MinhTran2084/Fliptris_Console/Media/Back view.jpg

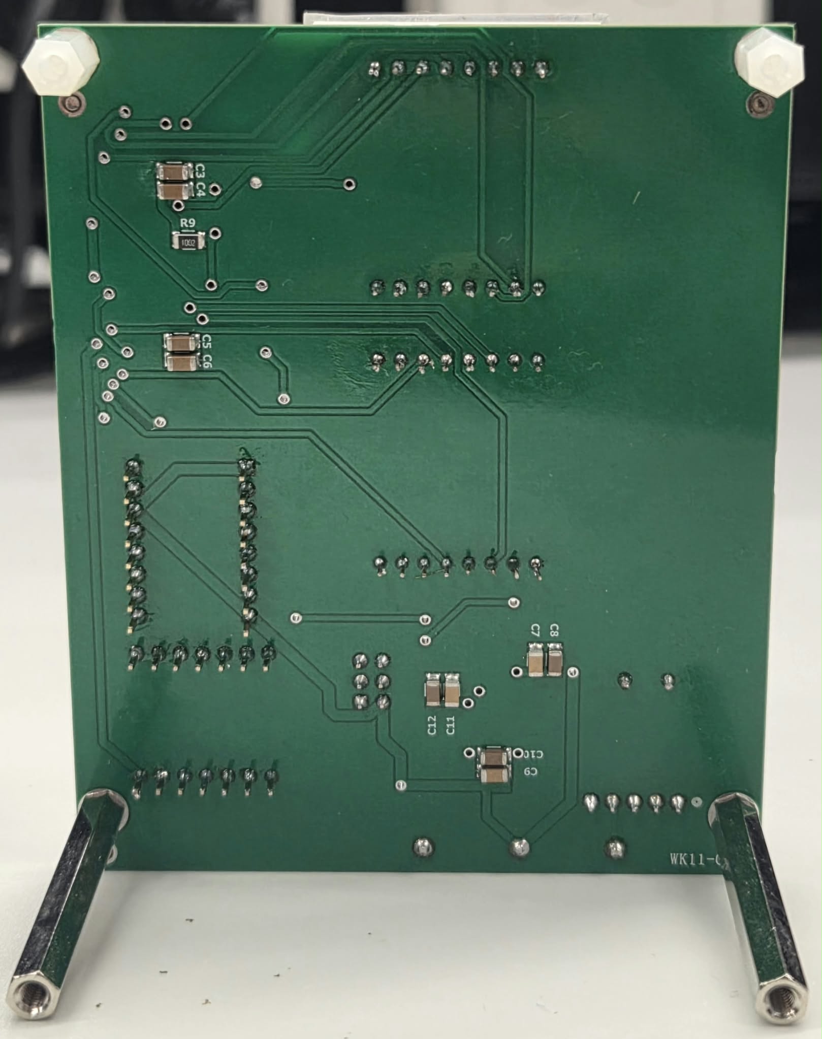
Media/Back view.jpg
