MinhTran2084/Fliptris_Console/Media/Front view.jpg

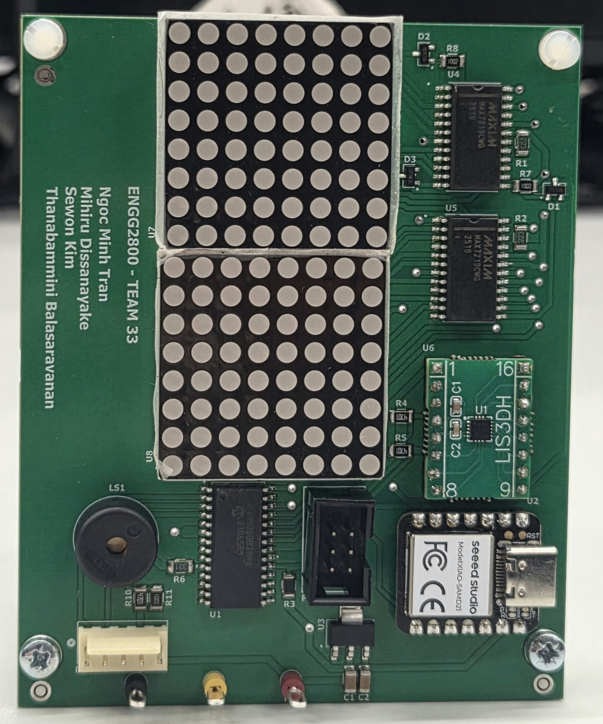
Media/Front view.jpg
