MinhTran2084/Fliptris_Console/Hardware_Altium/Documents/BOM.xlsx

Designator | Description | Quantity | Unit Price | Total price | Manufacturer | Manufacturer # | Supplier | Supplier # | RoHS link
U1 | IC MCU 8BIT 128KB FLASH 28SOIC | 1 | $2.66 | $2.66 | Microchip Technology | AVR128DB28-I/SO | DigiKey | 150-AVR128DB28-I/SO-ND | https://www.digikey.com.au/en/products/detail/microchip-technology/AVR128DB28-I-SO/12807360
U2 | Seeeduino Xiao SAMD21 | 1 | $8.25 | $8.25 | Seeed Studio | 102010328 | ETSG | 24-01-01 | See ETSG
U3 | IC REG LINEAR 3.3V 800MA SOT-223 | 1 | $0.89 | $0.89 | onsemi | LM1117MPX-33NOPB | DigiKey | 488-LM1117MPX-33NOPBTR-ND | https://www.digikey.com.au/en/products/detail/onsemi/LM1117MPX-33NOPB/13559871
U4, U5 | IC DRVR 7 SEGMNT 8 DIGIT 24SOIC | 2 | $29.67 | $59.34 | Analog Devices Inc./Maxim Integrated | MAX7219CWG+T | DigiKey | MAX7219CWG+TTR-ND | https://www.digikey.com.au/en/products/detail/analog-devices-inc-maxim-integrated/MAX7219CWG-T/1514450
U6 | LIS3DH Accelerometer Breakout | 1 | $2.40 | $2.40 | ETSG | 07-40-01 | ETSG | 07-40-01 | See ETSG
U7, U8 | 8x8 LED Matrix | 2 | $6.36 | $12.72 | Luckylight Electronics Co., Ltd. | KWM-30881CVB | ETSG | 28-06-05 | See ETSG
P1 | 2x3 Pin Header (UPDI) | 1 | $2.61 | $2.61 | ETSG | 01-77-01 | ETSG | 01-77-01 | See ETSG
P2 | KK Style Vertical Male Header (5 Pin) | 1 | $0.03 | $0.03 | ETSG | 24-03-02 | ETSG | 24-03-02 | See ETSG
P3 | KK Style Crimp Terminal Housing (5 Way) | 1 | $0.02 | $0.02 | ETSG | 24-03-04 | ETSG | 24-03-04 | See ETSG
P4, P5, P6, P7, P8 | KK Style Crimp Terminals | 5 | $0.01 | $0.05 | ETSG | 24-03-01 | ETSG | 24-03-01 | See ETSG
D1, D2, D3 | DIODE SMT Schottky Barrier | 3 | $0.42 | $1.26 | Infineon Technologies | BAT5404E6327HTSA1 | ETSG | 63-07-12 | See datasheet
TP1 | Red Test Point | 1 | $0.38 | $0.38 | Keystone Electronics | 5010 | ETSG | 01-95-01 | See ETSG
TP2 | Yellow Test Point | 1 | $0.40 | $0.40 | Keystone Electronics | 5011 | ETSG | 01-95-02 | See ETSG
TP3 | Black Test Point | 1 | $0.40 | $0.40 | Keystone Electronics | 5014 | ETSG | 01-96-01 | See ETSG
C1, C2, C4, C6 | CAP CER 10UF 25V X7R 1206 | 4 | $0.22 | $0.88 | Murata Electronics | GRM31CR71E106KA12L | ETSG | 62-01-07 | See datasheet
C3, C5, C8, C10, C12 | CAP CER 0.1uF 10V X7R 1206 | 5 | $0.17 | $0.85 | Würth Elektronik | 885012208009 | ETSG | 64-07-07 | See datasheet
C7, C9, C11 | CAP CER 1UF 10V X7R 1206 | 3 | $0.31 | $0.93 | Würth Elektronik | 885012208013 | DigiKey | 732-7685-2-ND | See datasheet
R1, R2 | 22K 1% 1/4W 1206 Resistor | 2 | $0.08 | $0.16 | Tyco Electronics | CRG1206F22K | ETSG | 63-04-08 | See datasheet
R3 | 1K 1% 1/4W 1206 Resistor | 1 | $0.02 | $0.02 | Tyco Electronics | CRG1206F1K0 | ETSG | 63-03-05 | See datasheet
R4, R5, R10 | 4.7K 1% 1/4W 1206 Resistor | 3 | $0.08 | $0.24 | Tyco Electronics | CRG1206F4K7 | ETSG | 63-04-01 | See datasheet
R6 | 330R 1% 1/4W 1206 Resistor | 1 | $0.08 | $0.08 | Tyco Electronics | CRG1206F330R | ETSG | 63-03-01 | See datasheet
R7, R8, R9, R11 | 10K 1% 1/4W 1206 Resistor | 4 | $0.01 | $0.04 | Tyco Electronics | CRG1206F10K | ETSG | 63-04-05 | See datasheet
LS1 | BUZZER PIEZO 3V 12.2MM TH | 1 | $1.08 | $1.08 | TDK | PS1240P02BT | DigiKey | 445-2525-1-ND | See datasheet
PCB | Custom Game Board (10x8.1cm) | 1 | $2.86 | $2.86 | — | — | Pinecone | https://pinecone2.uqcloud.net/pcb/6abf65aee9f09bf046ebfc34
HW1, HW2 | M3x9 Nylon F-F Standoff | 2 | $0.20 | $0.40 | ETSG | 10-41-02 | ETSG | 10-41-02 | See ETSG
HW3, HW4 | M3x40 Brass Nickel Plated F-F Standoff | 2 | $0.94 | $1.88 | ETSG | 10-44-03 | ETSG | 10-44-03 | See ETSG
HW5, HW6 | M3x6 Nylon Screw | 2 | $0.13 | $0.26 | ETSG | 10-34-01 | ETSG | 10-34-01 | See ETSG
HW7, HW8 | M3x6 Zinc Plated Steel Supadriv Screw | 2 | $0.06 | $0.12 | ETSG | 10-66-01 | ETSG | 10-66-01 | See ETSG
Total: |  |  |  | $101.21
