MinhTran2084/Fliptris_Console/Hardware_Altium/Components library/8x8 LED MATRIX/8x8-Dot-Matrix-LED.stp

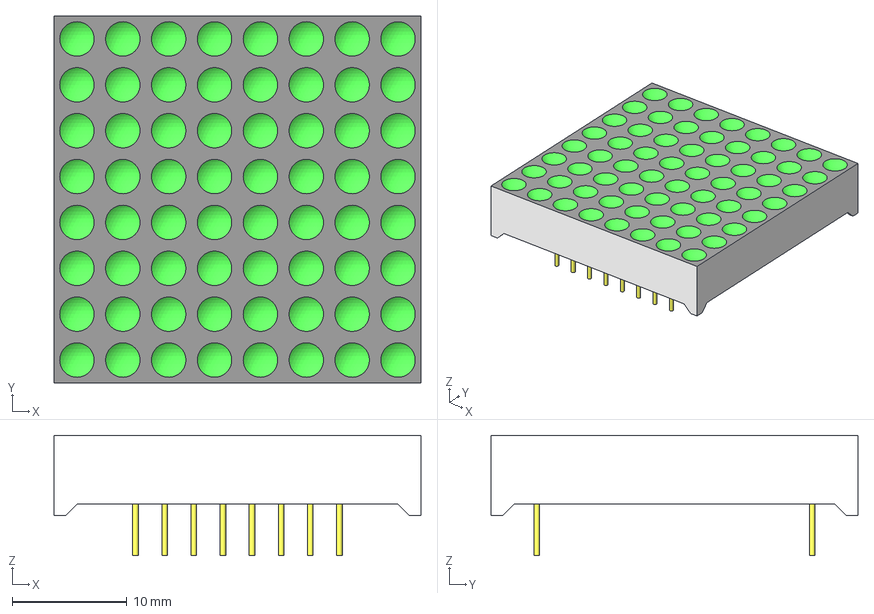
[picture p3: CAD file, 2026-11-03]
Hardware_Altium/Components library/8x8 LED MATRIX/8x8-Dot-Matrix-LED.stp
32.0 x 32.0 x 10.5 mm
