MinhTran2084/Fliptris_Console/Hardware_Altium/Components library/Buzzer/PS1240P02BT.step

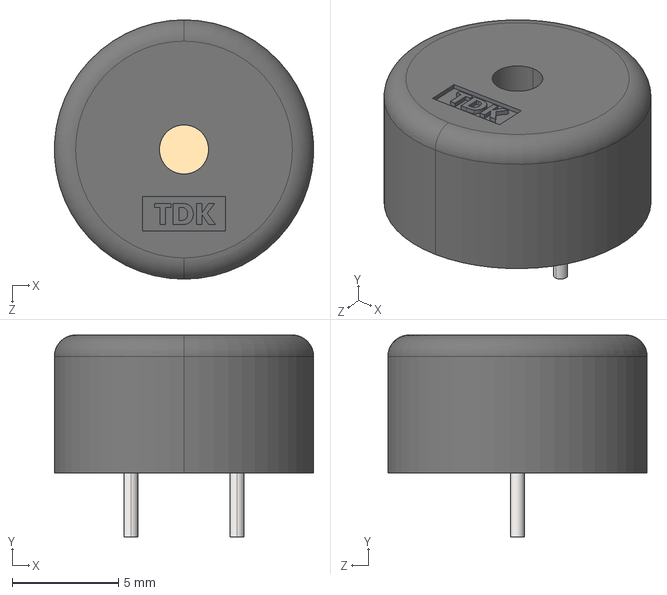
[picture p4: CAD file, 2026-11-03]
Hardware_Altium/Components library/Buzzer/PS1240P02BT.step
12.2 x 9.50 x 12.2 mm
