MinhTran2084/Fliptris_Console/Hardware_Altium/Components library/LIB_AVR128DB28-I_SP/AVR128DB28-I_SP.stp

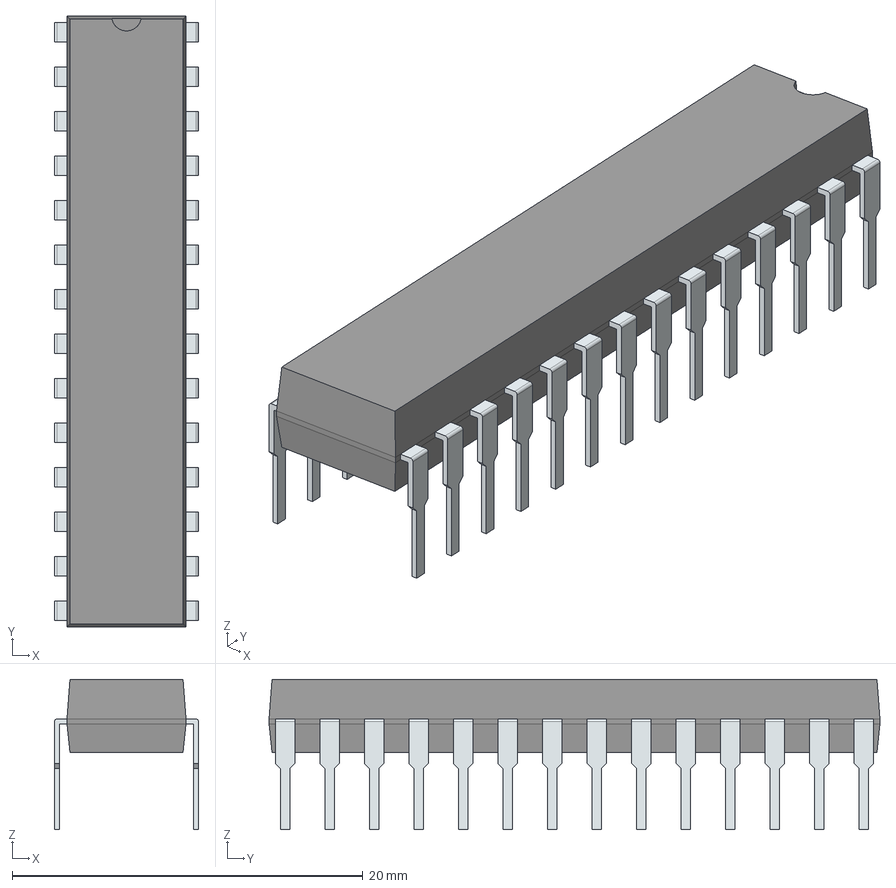
[picture p5: CAD file, 2026-11-03]
Hardware_Altium/Components library/LIB_AVR128DB28-I_SP/AVR128DB28-I_SP.stp
8.22 x 34.9 x 8.58 mm
PinsArrayLR
