MinhTran2084/Fliptris_Console/Hardware_Altium/Components library/LIB_IS31FL3731-SALS2-TR/IS31FL3731-SALS2-TR.stp

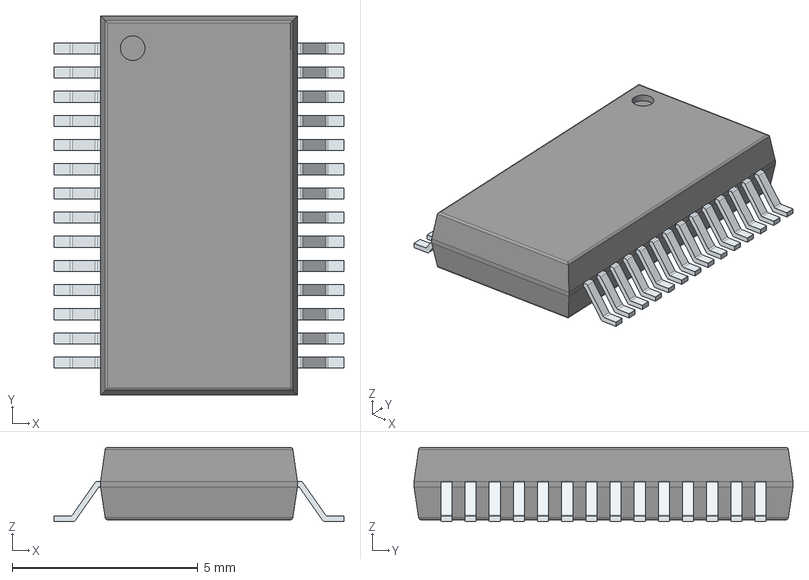
[picture p6: CAD file, 2026-11-03]
Hardware_Altium/Components library/LIB_IS31FL3731-SALS2-TR/IS31FL3731-SALS2-TR.stp
7.80 x 10.2 x 2.00 mm
PinsArrayLR
