MinhTran2084/Fliptris_Console/Hardware_Altium/Components library/Schottky diode/BAT5404E6327HTSA1/SOT23_INF.step

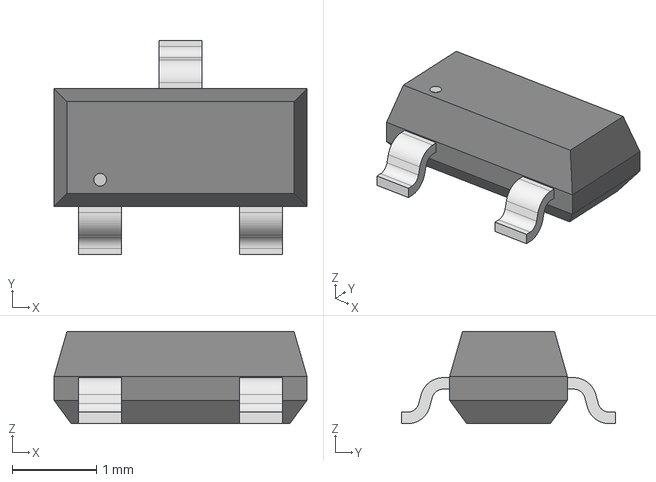
[picture p7: CAD file, 2026-11-03]
Hardware_Altium/Components library/Schottky diode/BAT5404E6327HTSA1/SOT23_INF.step
3.00 x 2.54 x 1.09 mm
