MinhTran2084/Fliptris_Console/Hardware_Altium/Components library/Voltage Regulator/SOT223-318H_OSI.step

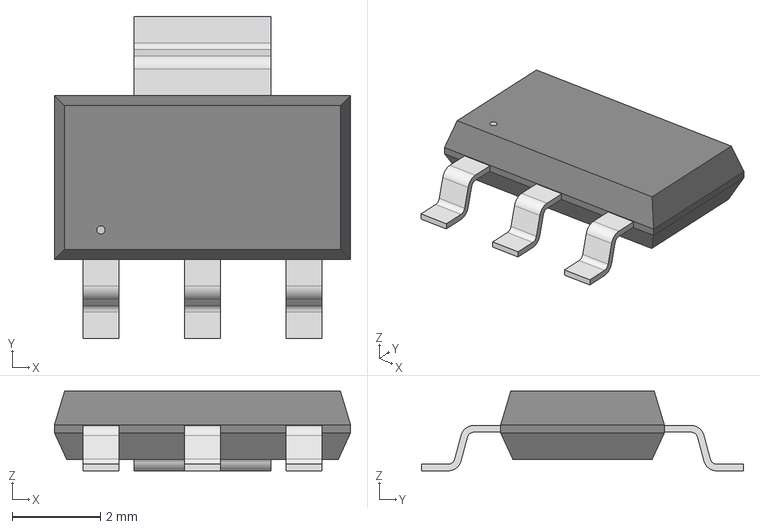
[picture p8: CAD file, 2026-11-03]
Hardware_Altium/Components library/Voltage Regulator/SOT223-318H_OSI.step
6.71 x 7.29 x 1.81 mm
