MinhTran2084/Fliptris_Console/(list of files, cad)

Other CAD files:
Hardware_Altium/Components library/Schottky diode/SOT23_INF.step
