MinhTran2084/Fliptris_Console/Hardware_Altium/Documents/Fliptris_Schematics.pdf

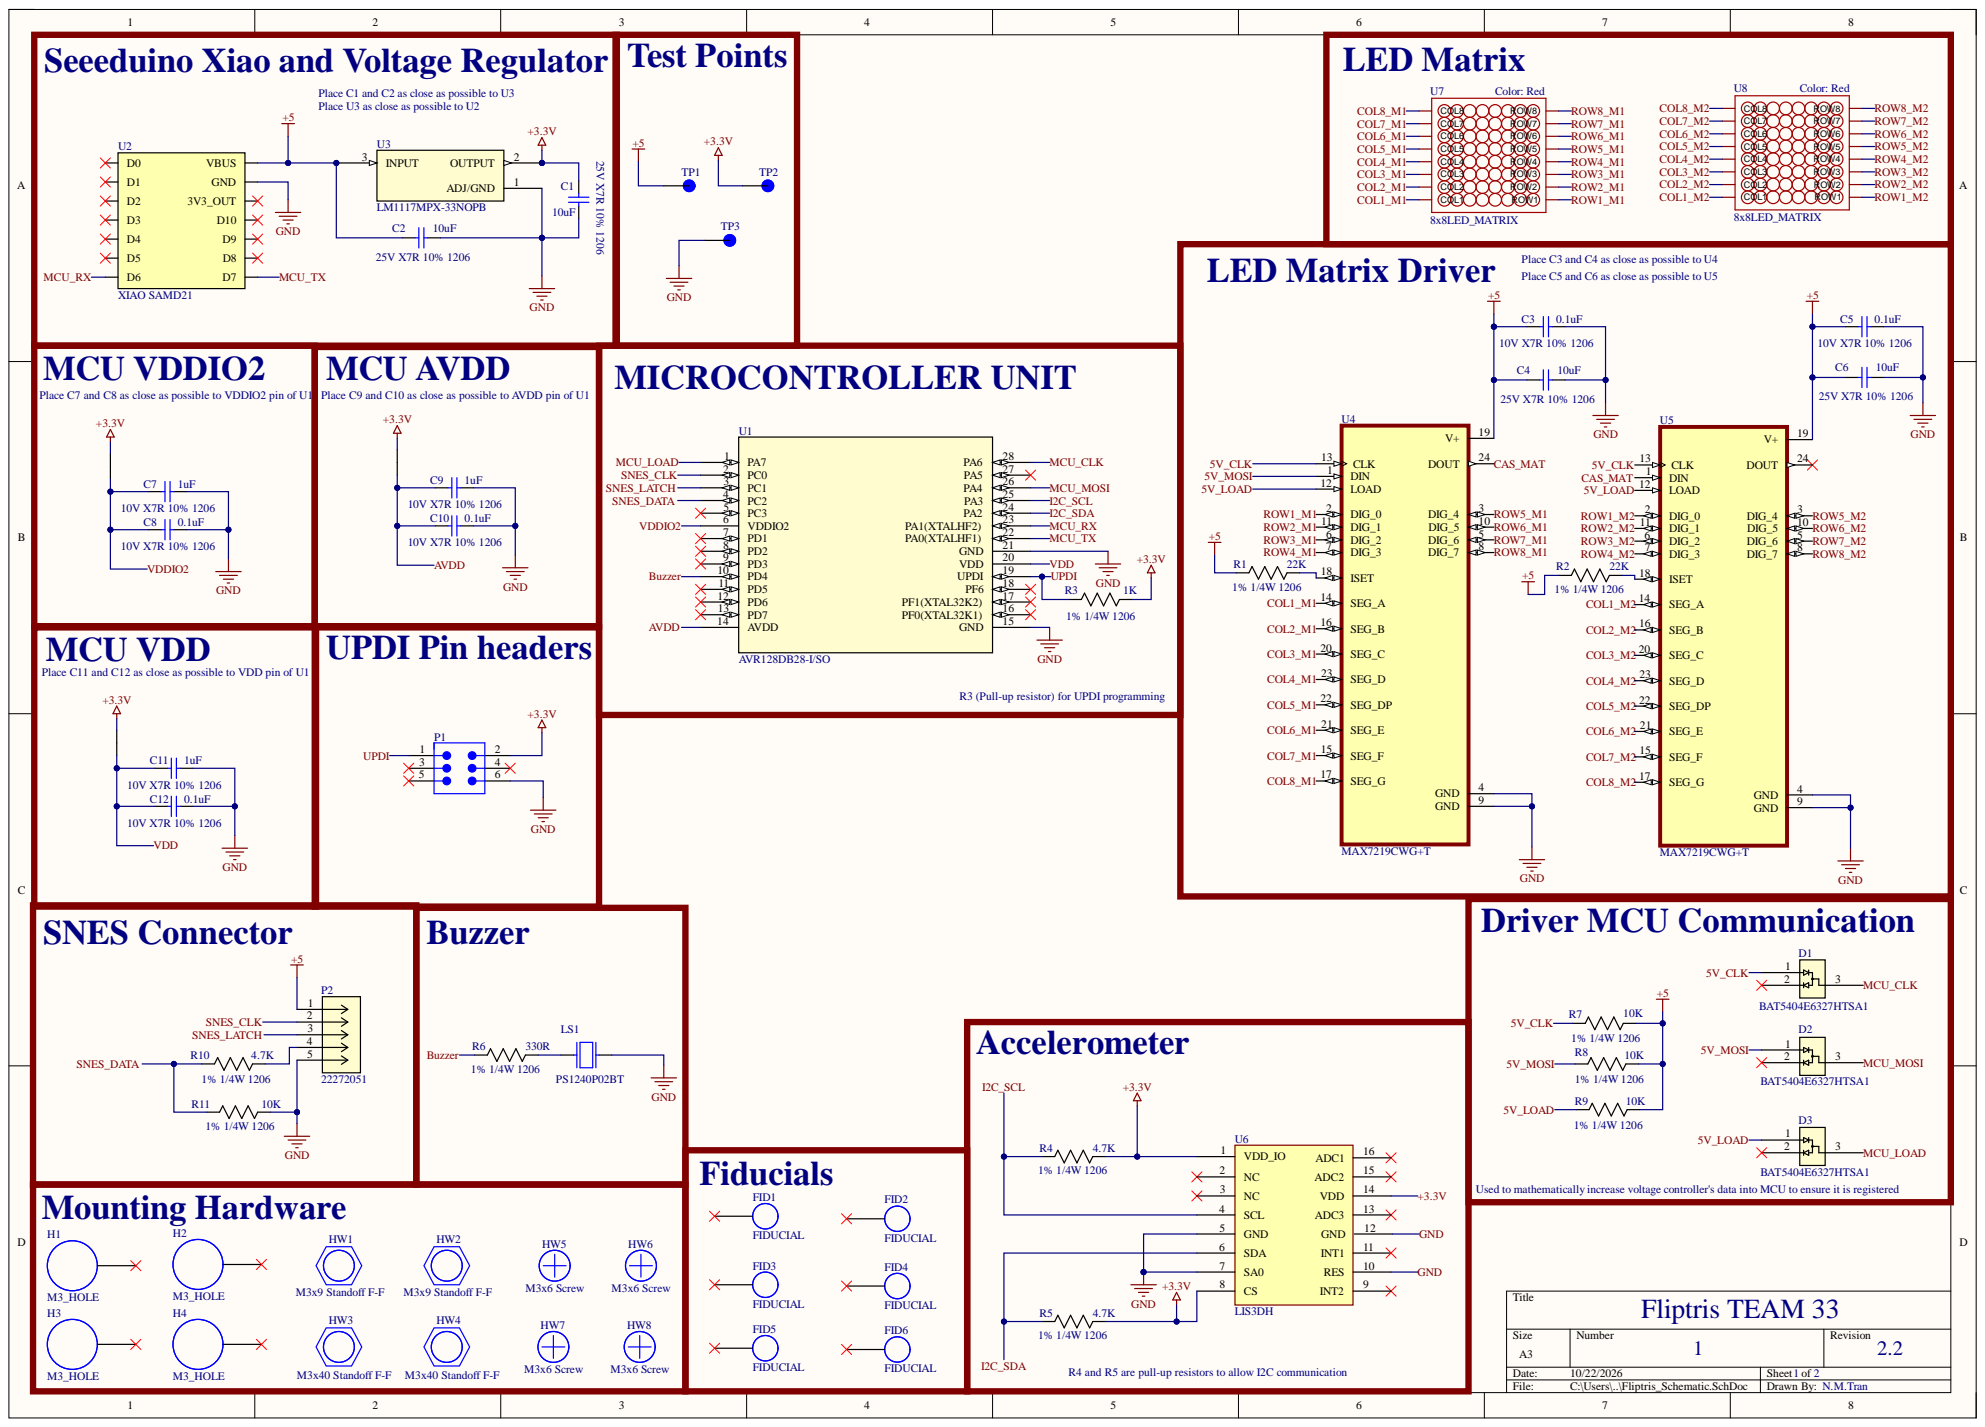
[picture p9: page 1]

Seeeduino Xiao and Voltage Regulator

Place C1 and C2 as close as possible to U3
Place U3 as close as possible to U2

Place C3 and C4 as close as possible to U4
Place C5 and C6 as close as possible to U5

Place C11 and C12 as close as possible to VDD pin of U1

R3 (Pull-up resistor) for UPDI programming

Used to mathematically increase voltage controller's data into MCU to ensure it is registered

GND 5
SDA 6

R4 and R5 are pull-up resistors to allow I2C communication

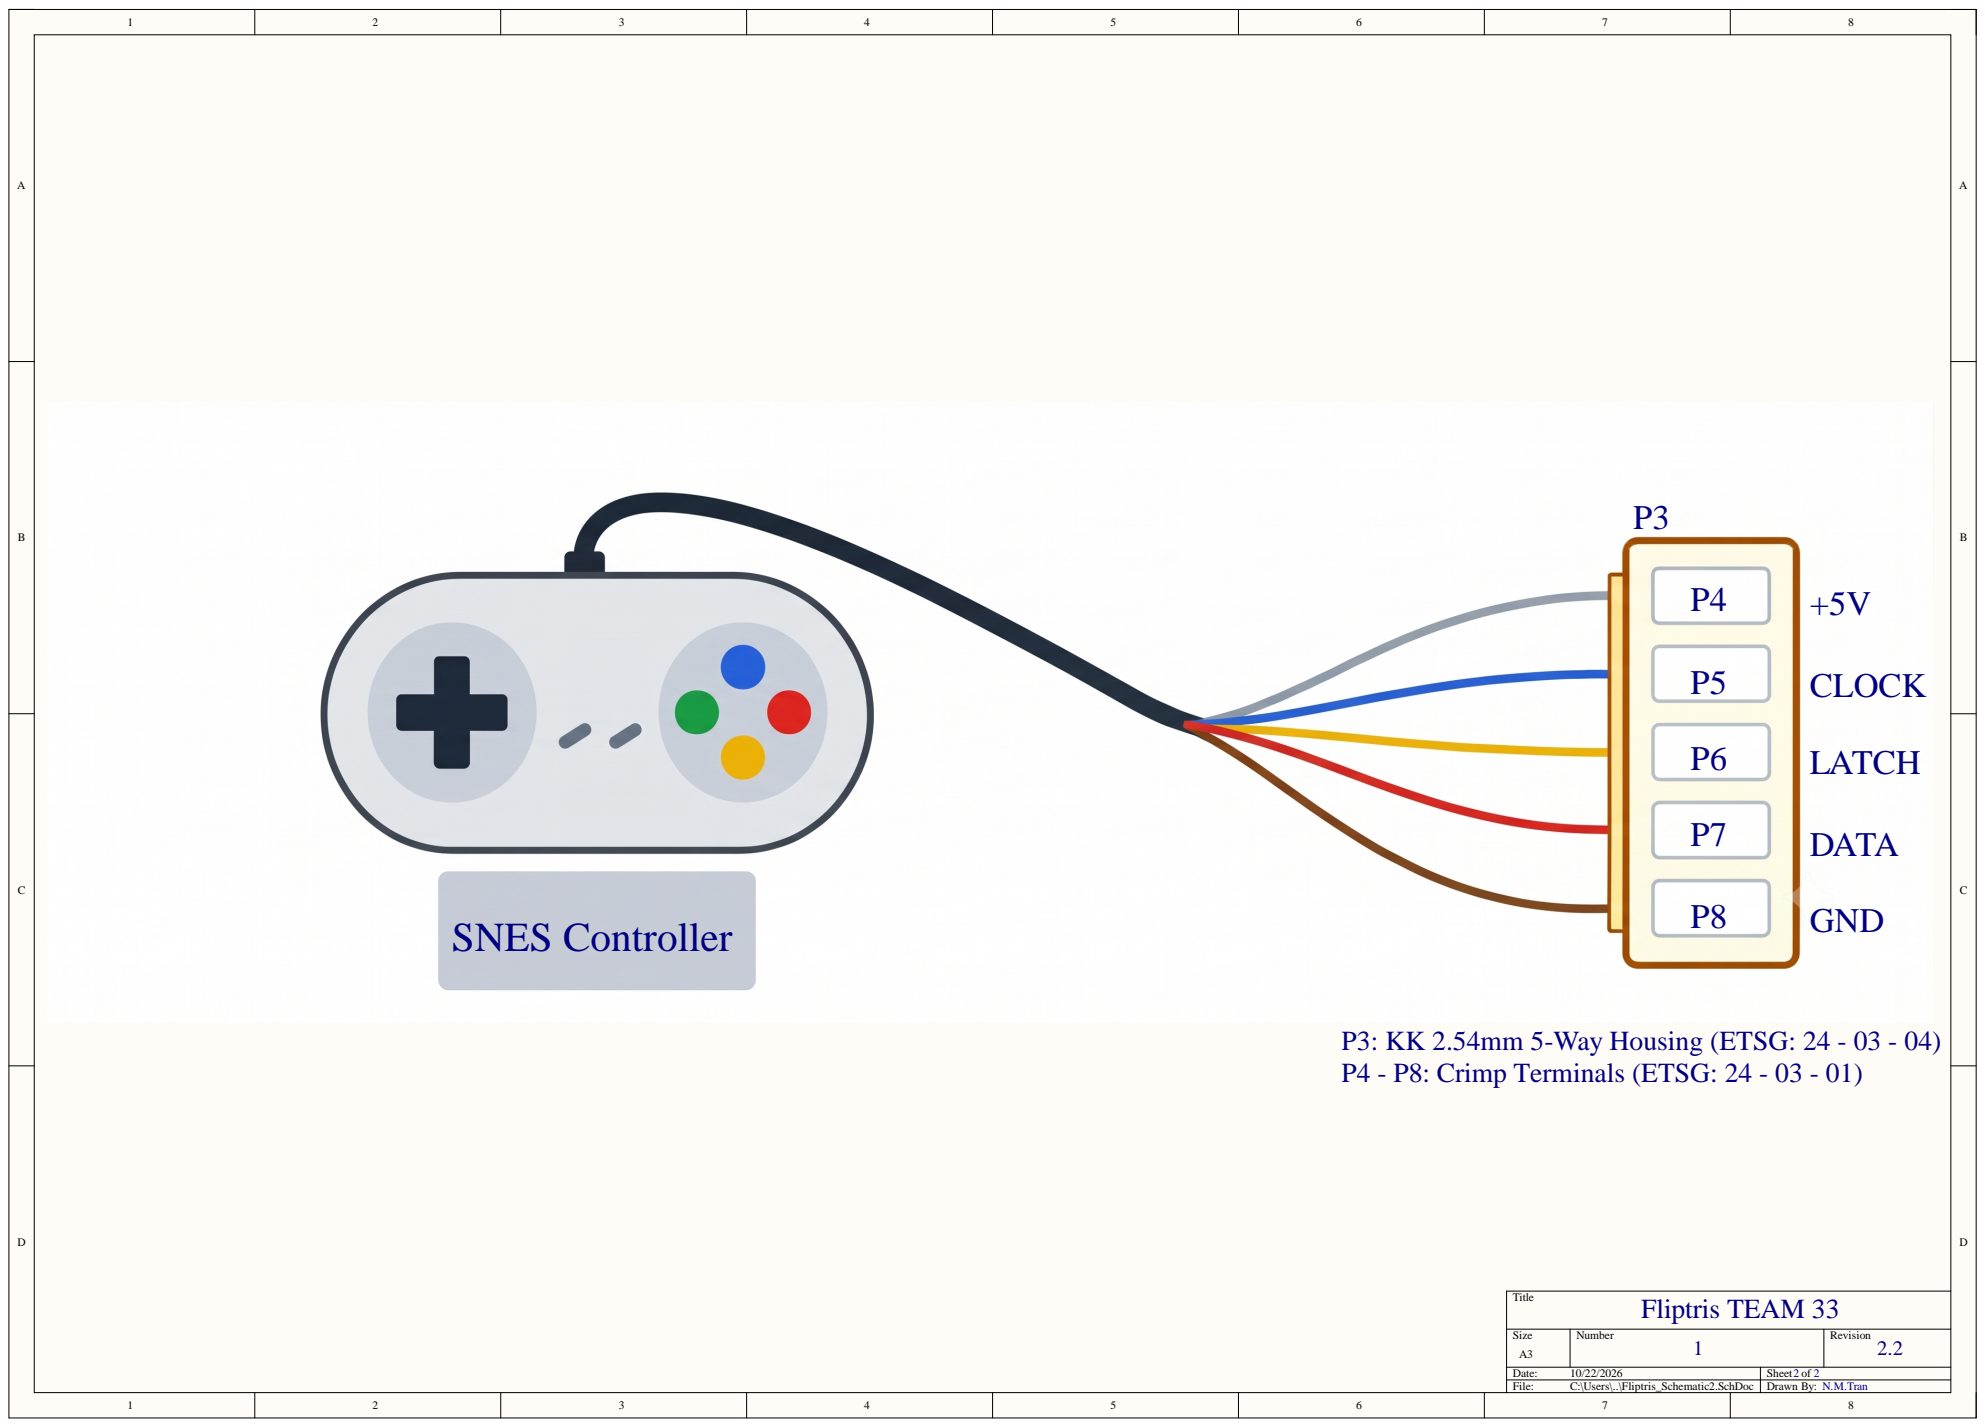
[picture p10: page 2]

P3: KK 2.54mm 5-Way Housing (ETSG: 24 - 03 - 04)
P4 - P8: Crimp Terminals (ETSG: 24 - 03 - 01)
