MinhTran2084/Fliptris_Console/Hardware_Altium/Documents/Fliptris_Schematics_PCBArtwork.pdf

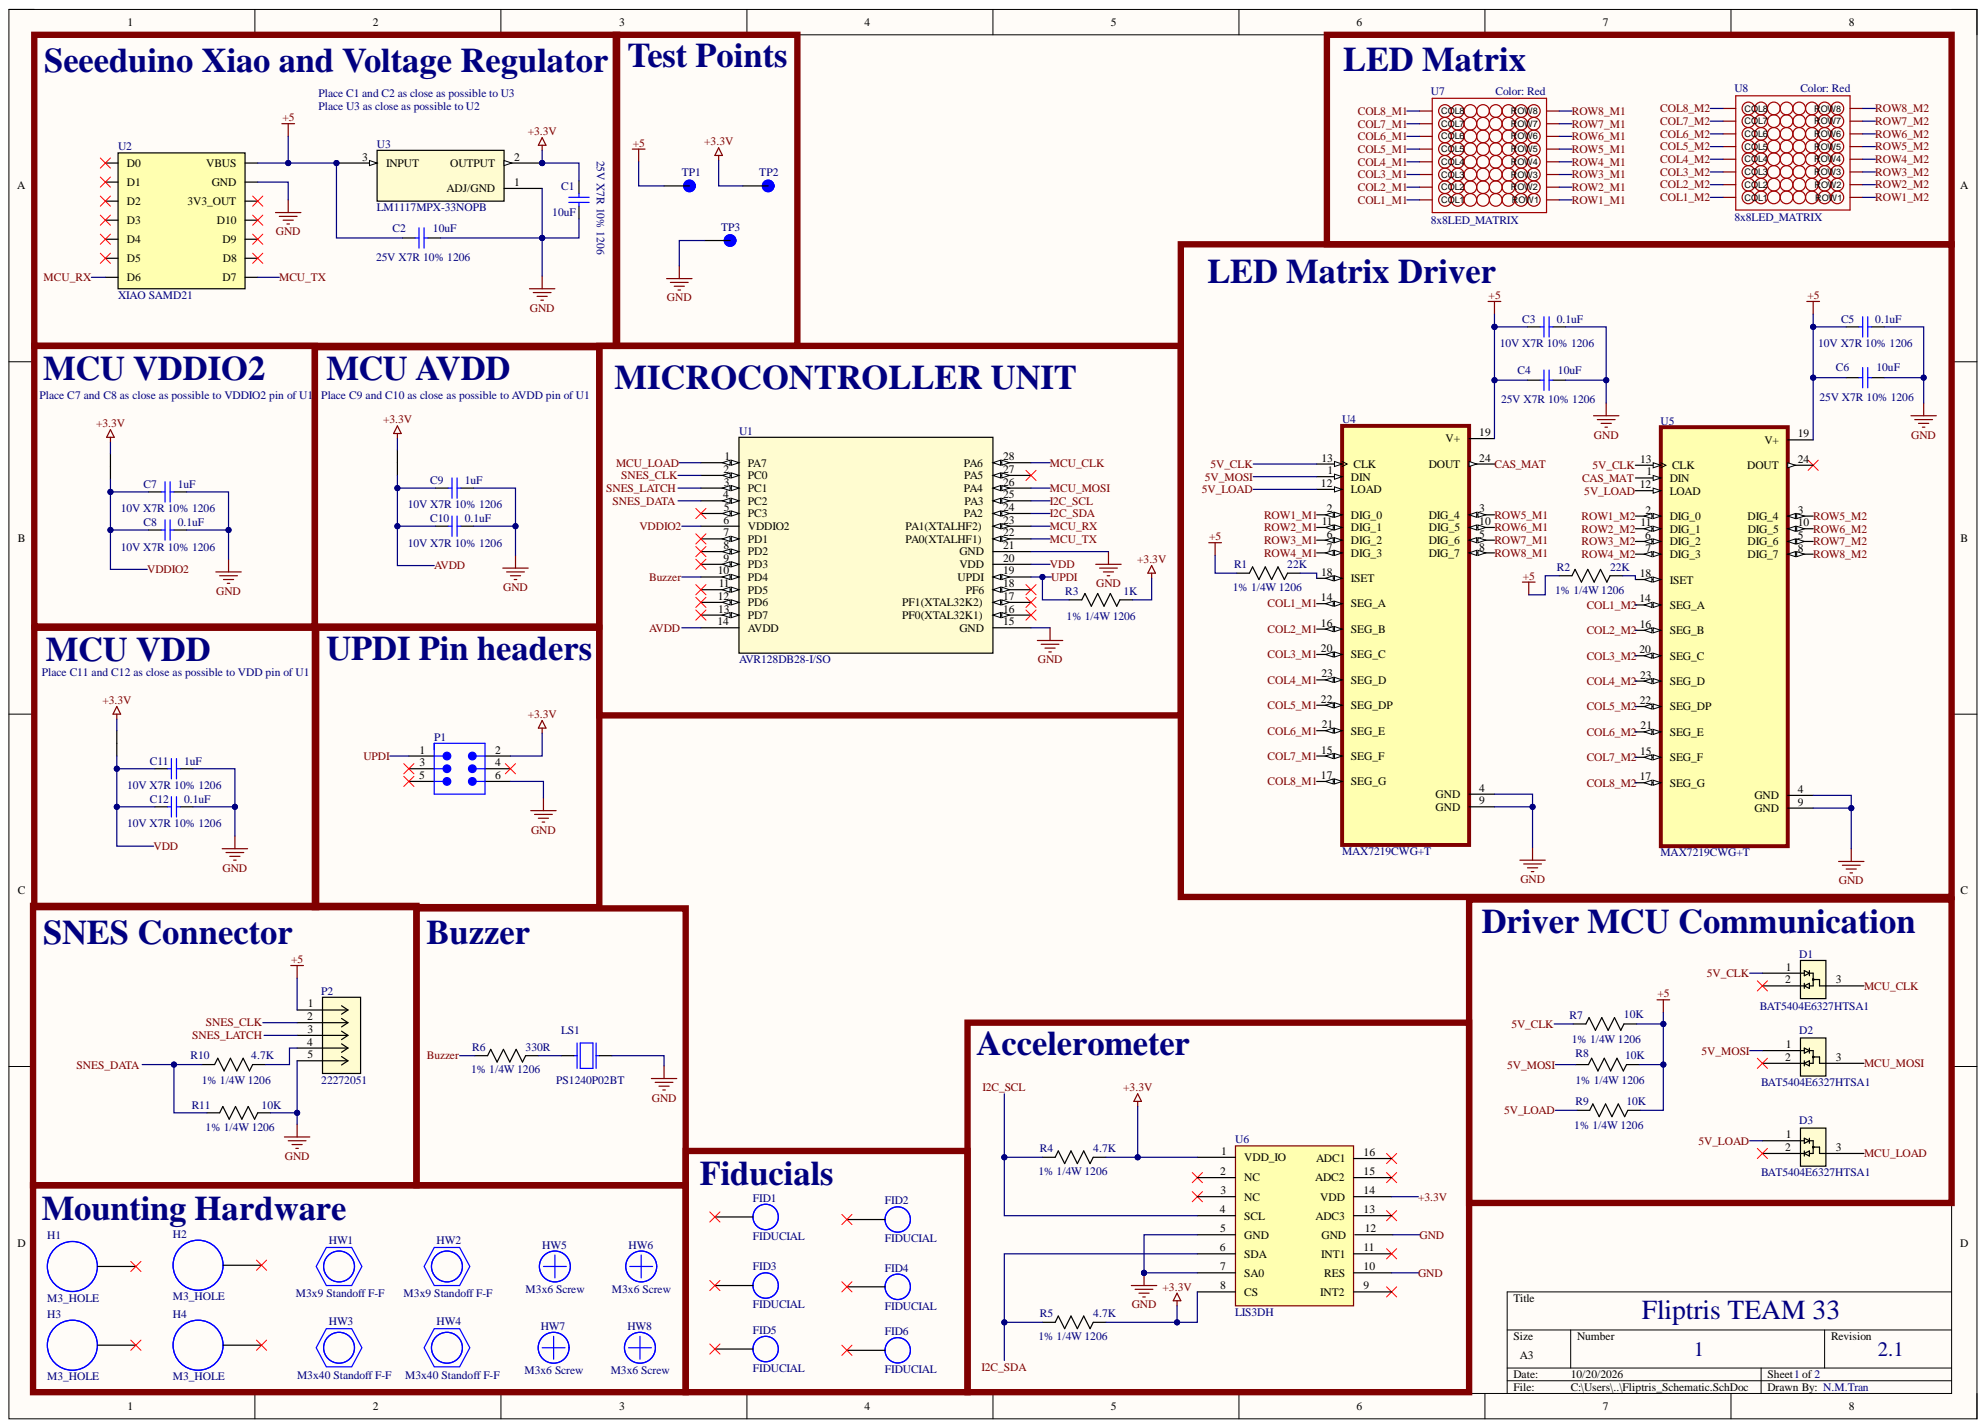
[picture p11: page 1]

Seeeduino Xiao and Voltage Regulator

Place C1 and C2 as close as possible to U3
Place U3 as close as possible to U2

Place C11 and C12 as close as possible to VDD pin of U1

SDA 6

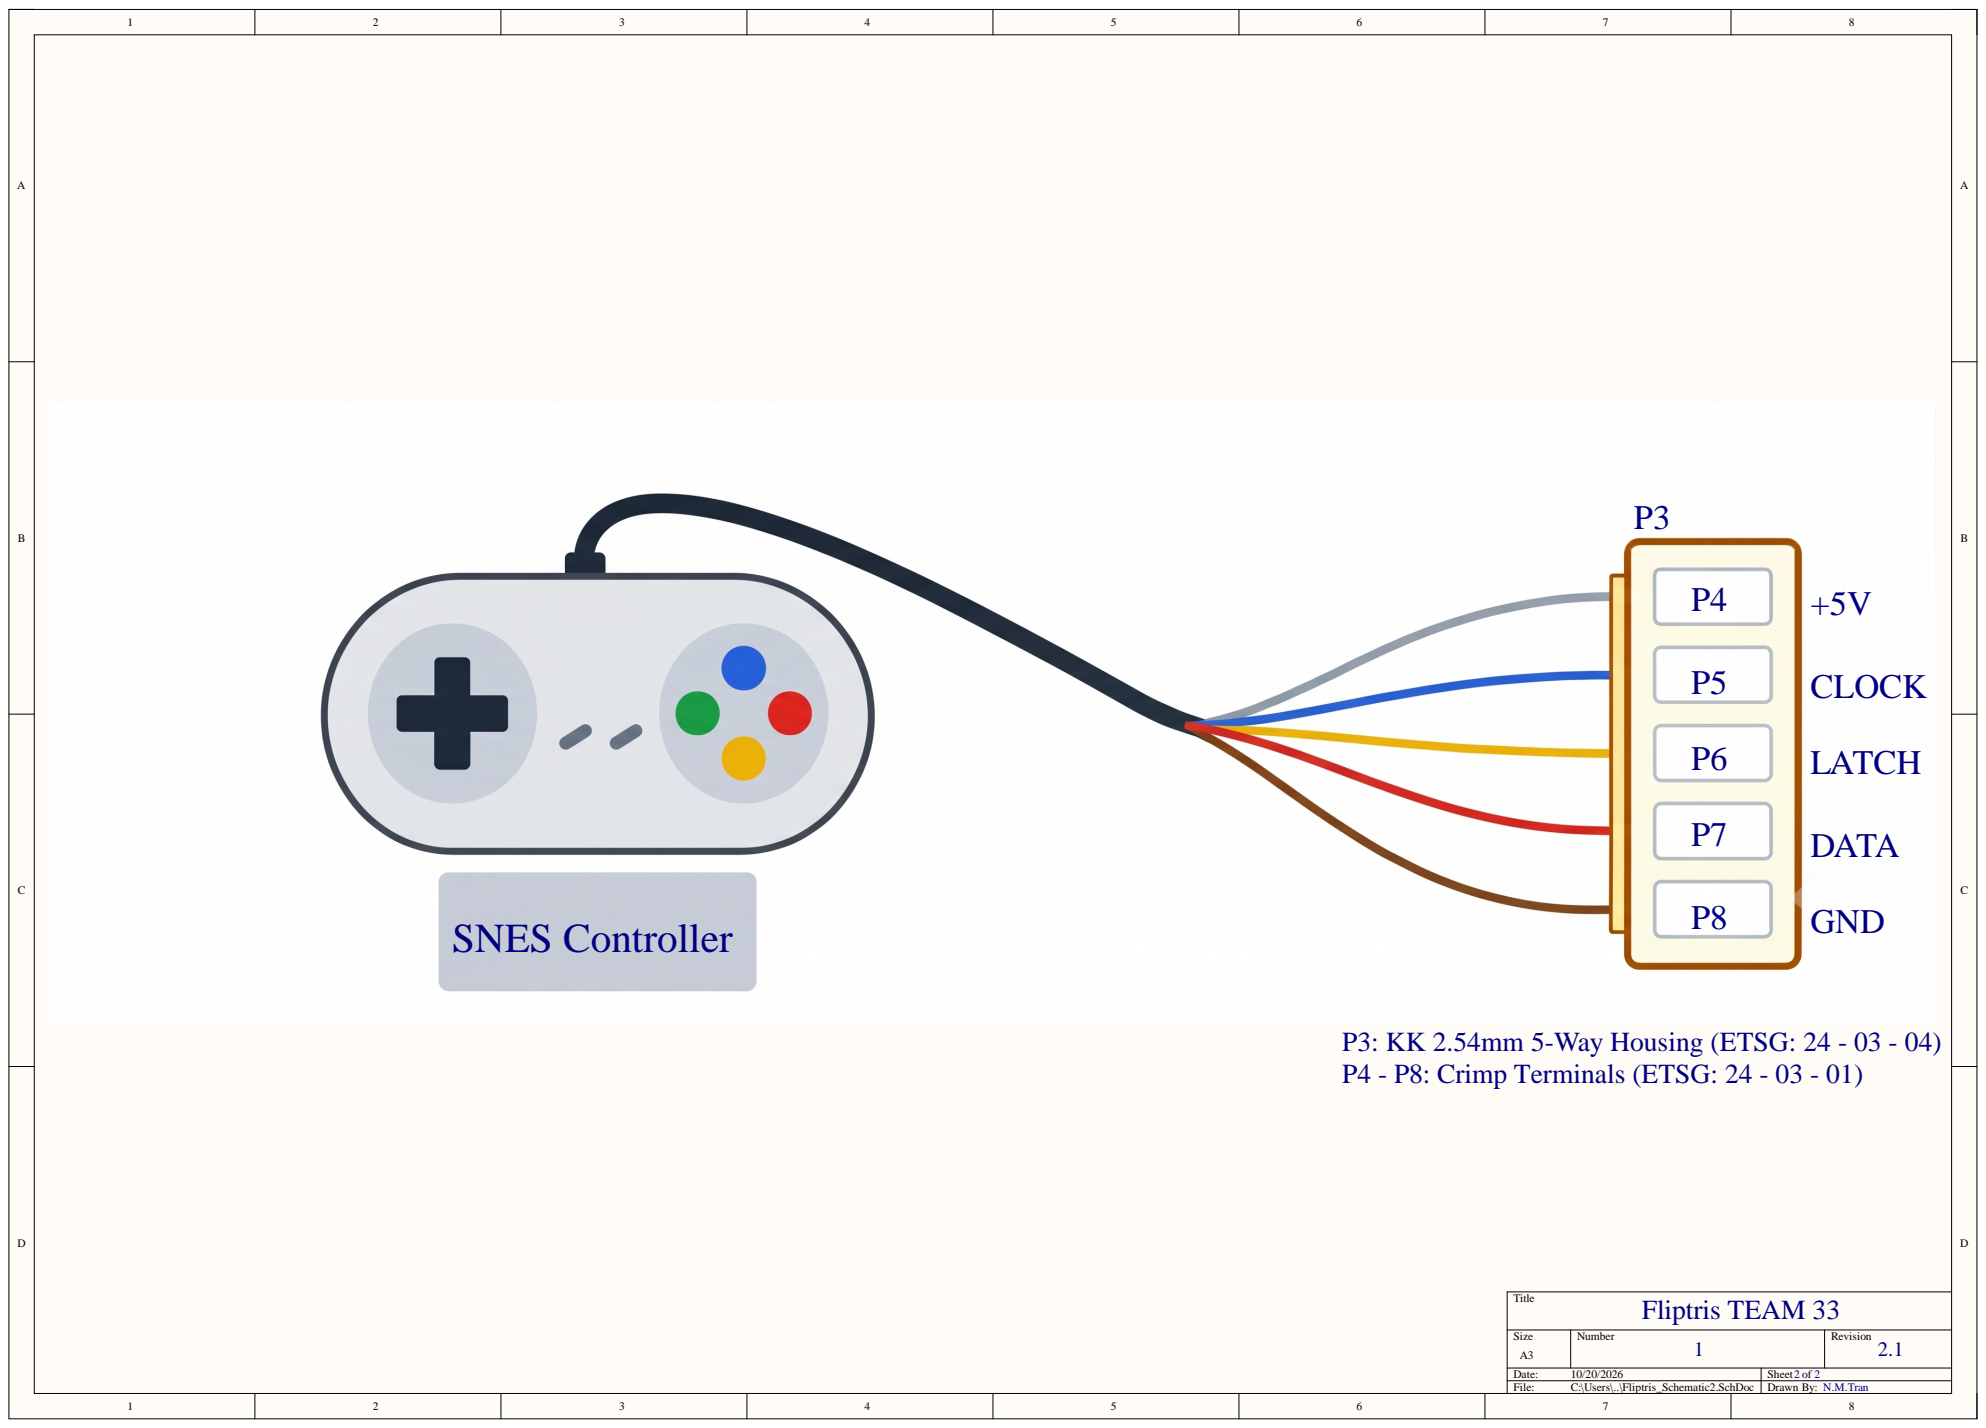
[picture p12: page 2]

P3: KK 2.54mm 5-Way Housing (ETSG: 24 - 03 - 04)
P4 - P8: Crimp Terminals (ETSG: 24 - 03 - 01)

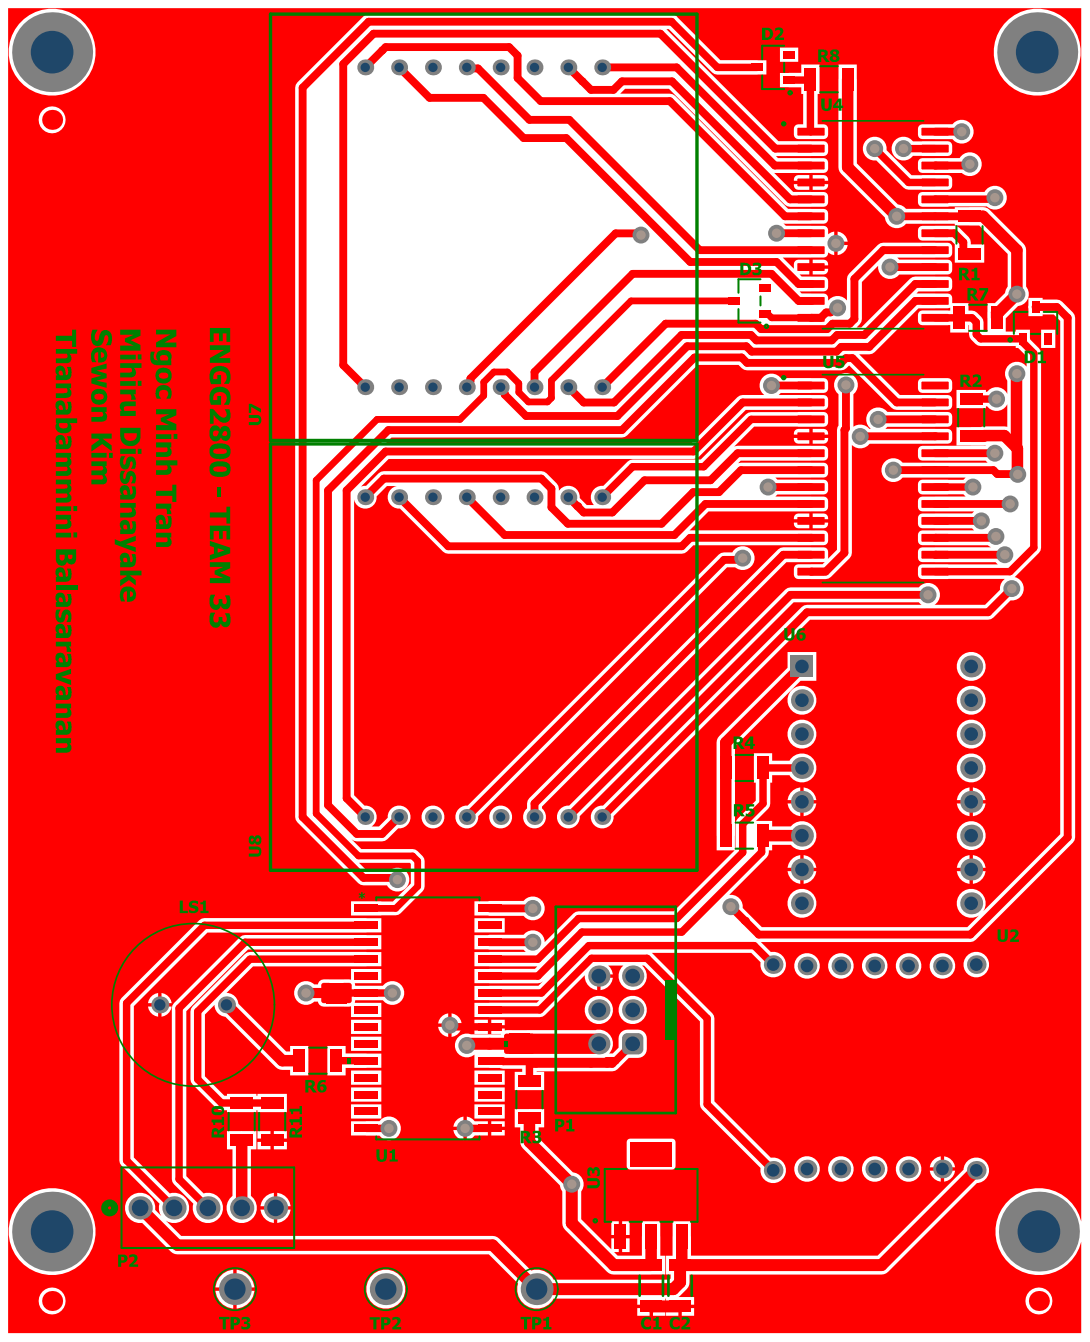
[picture p13: page 3]

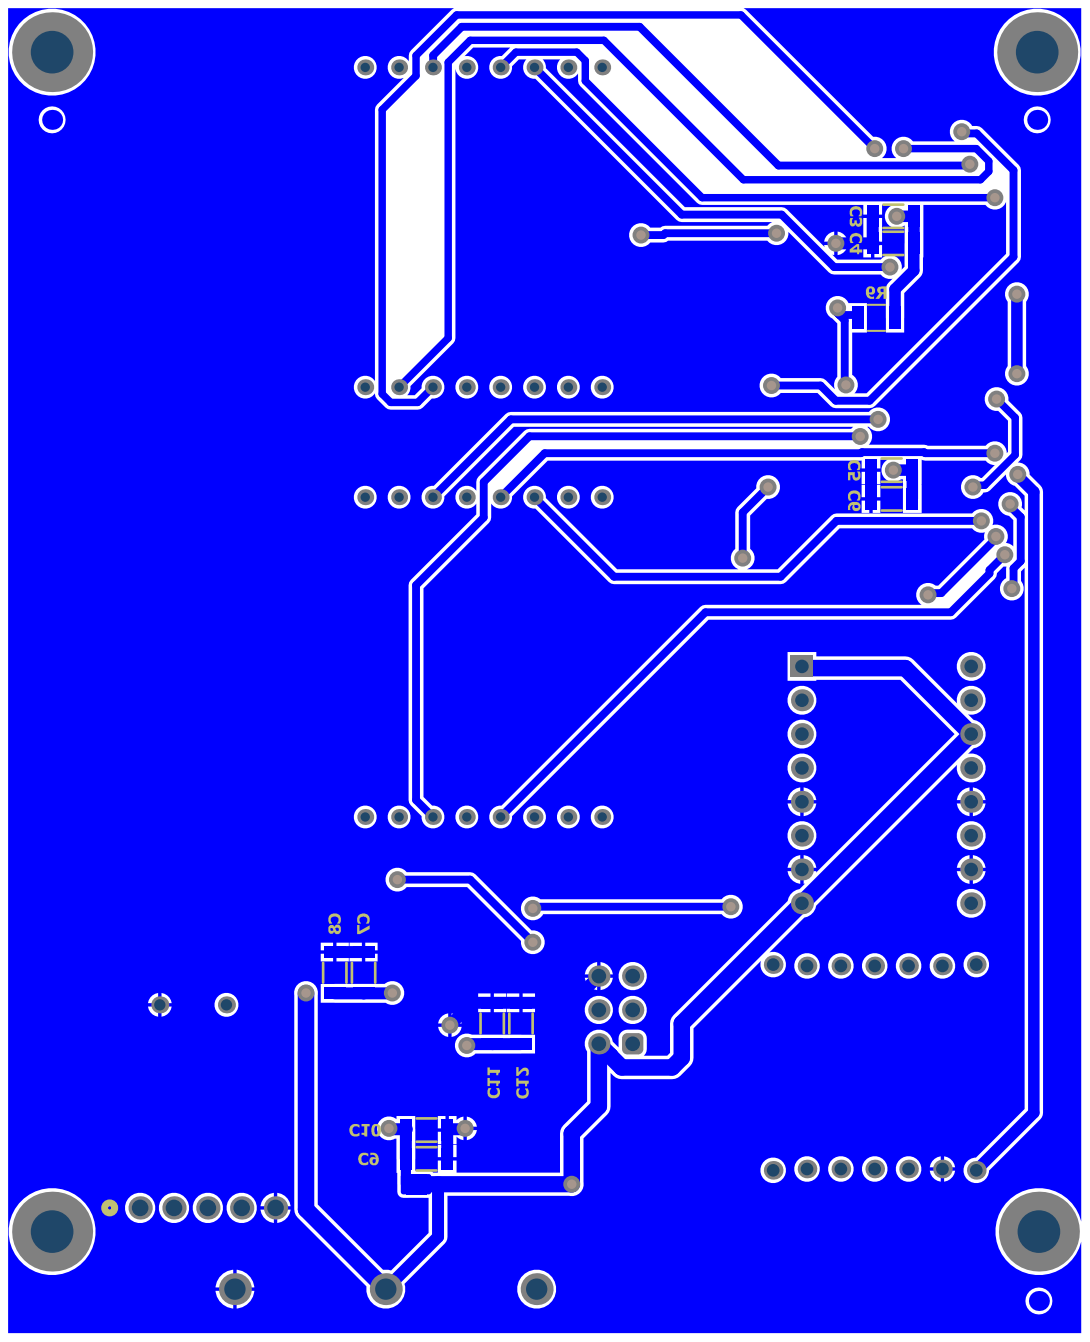
[picture p14: page 4]
