MinhTran2084/Fliptris_Console/(list of files, drawings)

Other design files:
Hardware_Altium/Components library/8x8 LED MATRIX/8x8LEDMATRIX.PcbLib
Hardware_Altium/Components library/8x8 LED MATRIX/8x8LEDMATRIX.SchLib
Hardware_Altium/Components library/22272051/22272051.PcbLib
Hardware_Altium/Components library/22272051/22272051.SchLib
Hardware_Altium/Components library/Accelerometer/LIS3DH.PcbLib
Hardware_Altium/Components library/Accelerometer/LIS3DH.SchLib
Hardware_Altium/Components library/AVR128DB28_I_SO/AVR128DB28-ISO.PcbLib
Hardware_Altium/Components library/AVR128DB28_I_SO/AVR128DB28-ISO.SchLib
Hardware_Altium/Components library/Fiducial/Fiducial.PcbLib
Hardware_Altium/Components library/Fiducial/Fiducial.SchLib
Hardware_Altium/Components library/LED_DRIVER/MAX7219CWG+T.SchLib
Hardware_Altium/Components library/LED_DRIVER/SOIC127P1032X265-24N.PcbLib
Hardware_Altium/Components library/LIB_AVR128DB28-I_SP/AVR128DB28-I_SP.SchLib
Hardware_Altium/Components library/LIB_AVR128DB28-I_SP/DIP794W56P254L3486H508Q28N.PcbLib
Hardware_Altium/Components library/MountedHole/MountedHole.SchLib
Hardware_Altium/Components library/Mounting Hardware/MountingHardware.SchLib
Hardware_Altium/Components library/NET_TIE/NET_TIE.PcbLib
Hardware_Altium/Components library/NET_TIE/NET_TIE.SchLib
Hardware_Altium/Components library/Schottky diode/BAT5404E6327HTSA1.PcbLib
Hardware_Altium/Components library/Schottky diode/BAT5404E6327HTSA1.SchLib
Hardware_Altium/Components library/Universal capacitor SMD/Universal capacitor SMD.PcbLib
Hardware_Altium/Components library/Universal capacitor SMD/Universal capacitor SMD.SchLib
Hardware_Altium/Components library/Universal capacitor/UNIV_CAP.PcbLib
Hardware_Altium/Components library/Universal capacitor/UNIV_CAP.SchLib
Hardware_Altium/Components library/Universal resistor SMD/Universal resistor SMD.PcbLib
Hardware_Altium/Components library/Universal resistor SMD/Universal resistor SMD.SchLib
Hardware_Altium/Components library/Universal resistor/UNIV_RES.PcbLib
Hardware_Altium/Components library/Universal resistor/UNIV_RES.SchLib
Hardware_Altium/Components library/UPDI 6-pin header/UPDI 6-pin header.PcbLib
Hardware_Altium/Components library/UPDI 6-pin header/UPDI 6-pin header.SchLib
Hardware_Altium/Components library/Voltage Regulator/LM1117MPX-33NOPB.PcbLib
Hardware_Altium/Components library/Voltage Regulator/LM1117MPX-33NOPB.SchLib
Hardware_Altium/Components library/XIAO SAMD21/Seeed_Studio_XIAO_Series.SchLib
Hardware_Altium/Components library/XIAO SAMD21/Seeed_Studio_XIAO_Series_Footprints.PcbLib
Hardware_Altium/Fliptris.PrjPcb
Hardware_Altium/Fliptris_PCB.PcbDoc
Hardware_Altium/Fliptris_Schematic2.SchDoc
Hardware_Altium/Fliptris_Schematic.SchDoc
