MinhTran2084/Fliptris_Console/Software/src/fliptris.h

/**
 * @file fliptris.h
 * @brief Public entry point for the Fliptris game.
 */

#ifndef FLIPTRIS_H
#define FLIPTRIS_H

/**
 * @brief Initialise all hardware and run the game forever.
 * @return Never returns.
 */
int fliptris_run(void);

#endif /* FLIPTRIS_H */
